Alex-Thiel/IceCutter/README.md

# IceCutter

This is the PCB and Code for the Temperature Controlled Ice Cutter for EEE4022S.
