Alex-Thiel/IceCutter/IceCutterPCB/IceCutterPCB.kicad_pcb

## KiCad design IceCutterPCB/IceCutterPCB.kicad_pcb (2022-10-09)

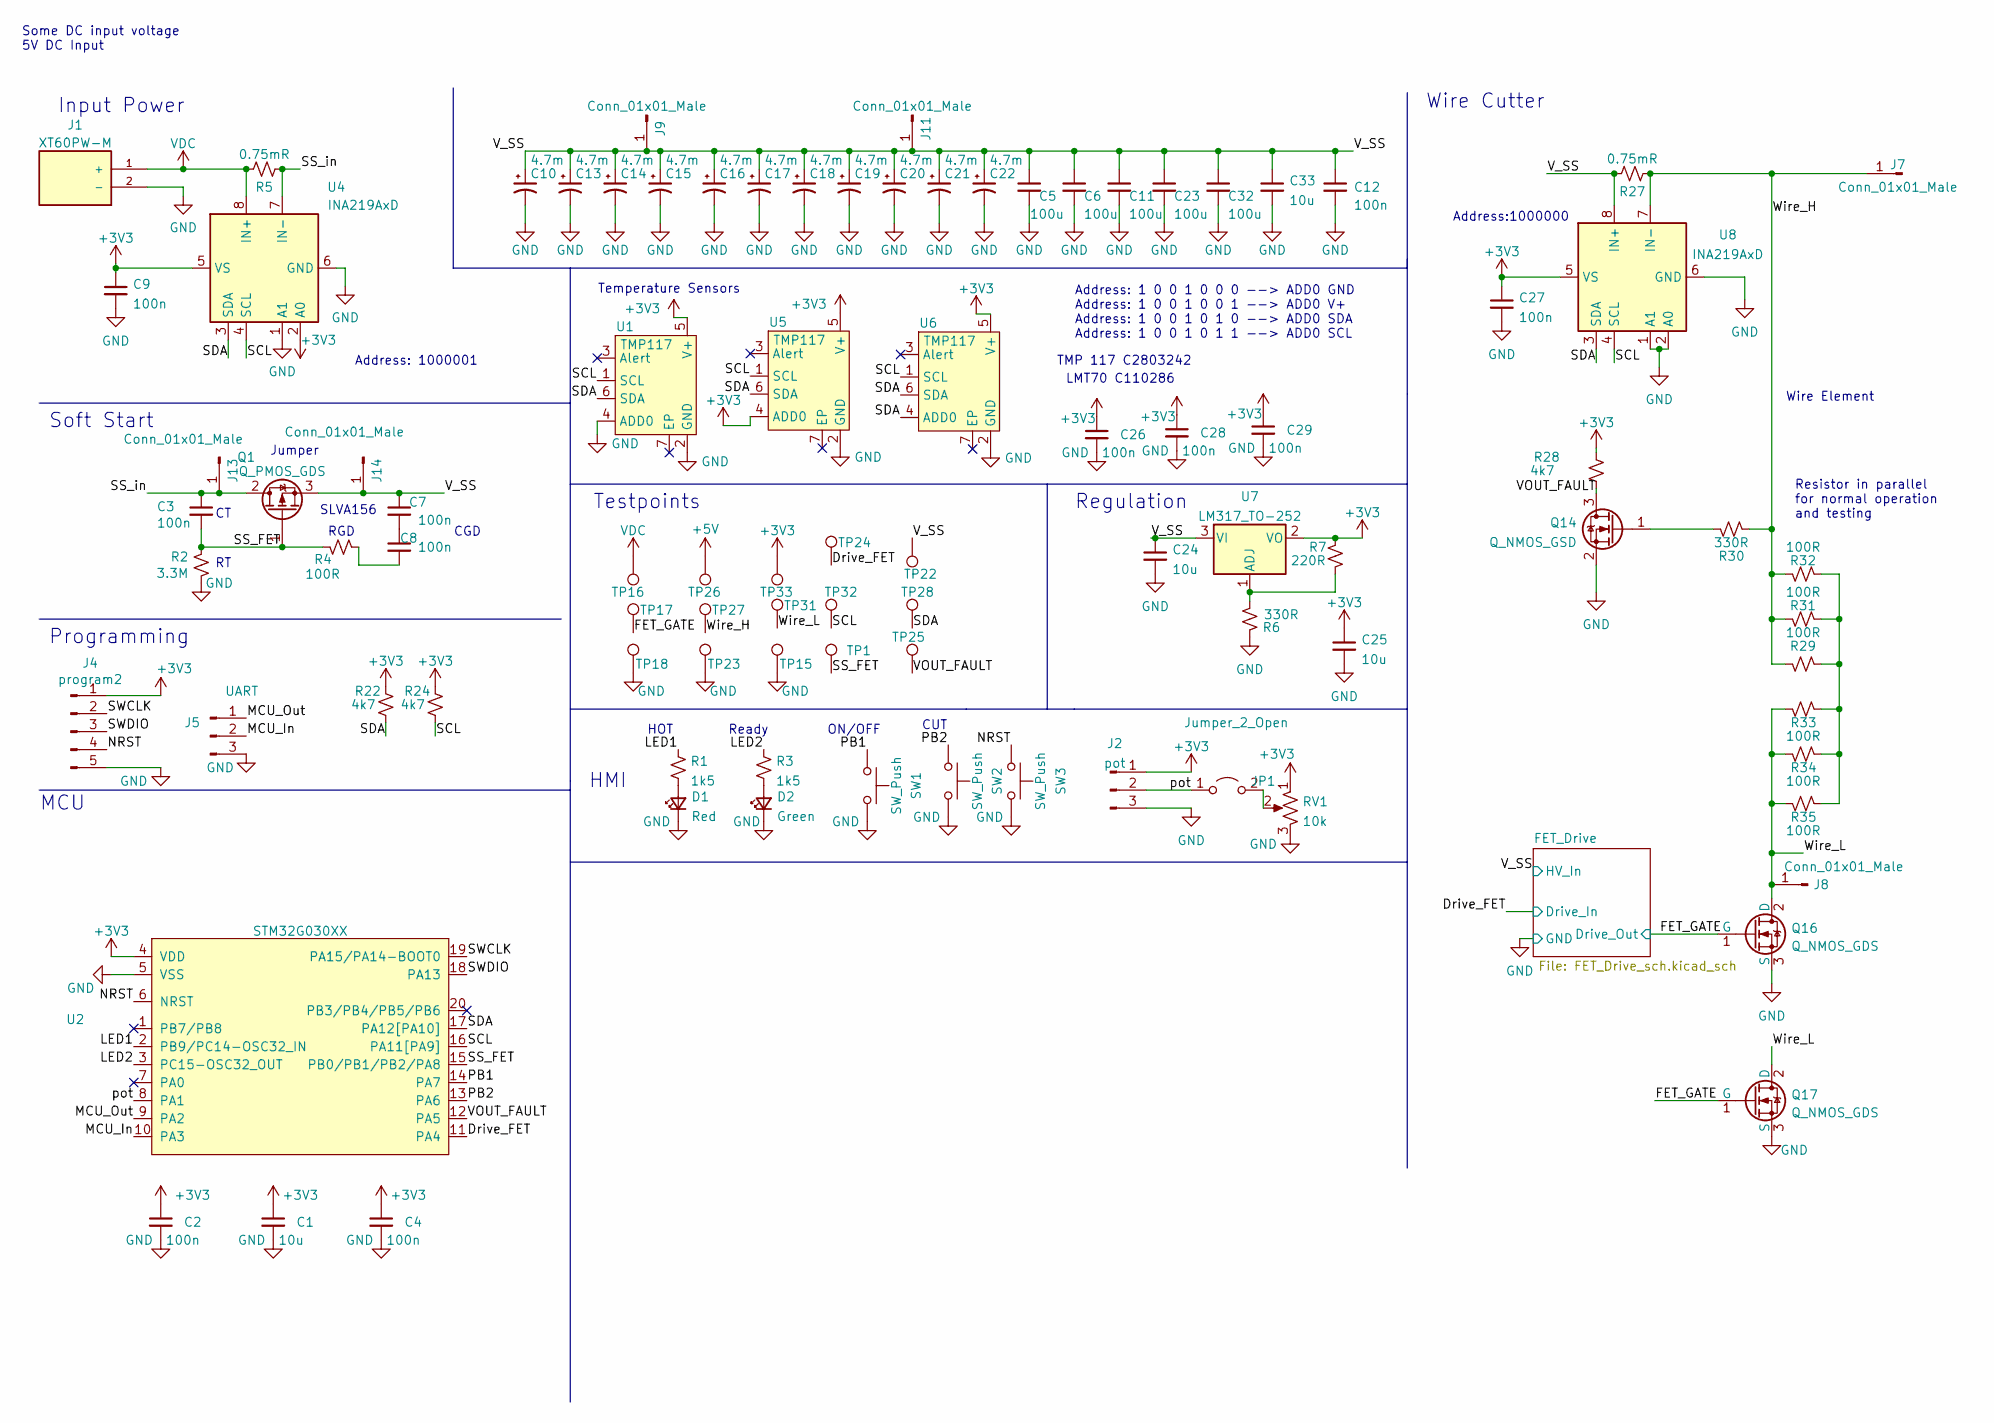
[picture p1: schematic IceCutterPCB.kicad_sch, Hot Wire Ice Cutter]

Parts:
C1, C24, C25, C33: 10u; C_0603_1608Metric; LCSC C96446
C2, C3, C4, C7, C8, C9, C12, C26, C27, C28, C29: 100n; C_0402_1005Metric; LCSC C307331
C5, C6, C11, C23, C32: 100u; C_1206_3216Metric; LCSC C15008
C10, C13, C14, C15, C16, C17, C18, C19, C20, C21, C22: 4.7m; CP_Radial_D14.0mm_P5.00mm
D1: Red; D_0603_1608Metric; LCSC C2286
D2: Green; D_0603_1608Metric; LCSC C72043
J1: XT60PW-M; AMASS_XT60PW-M; PARTREV V1.2
J2: pot; PinHeader_1x03_P2.54mm_Vertical
J4: program2; PinHeader_1x05_P2.54mm_Vertical
J5: UART; PinHeader_1x03_P2.54mm_Vertical
J7, J8, J9, J11, J13, J14: Conn_01x01_Male; SMD_Pad_15x10
JP1: Jumper_2_Open; SolderJumper-2_P1.3mm_Open_RoundedPad1.0x1.5mm
Q1: Q_PMOS_GDS; TO-252-2
Q14: Q_NMOS_GSD; SOT-23; LCSC C20917
Q16, Q17: Q_NMOS_GDS; TO-252-2; LCSC C709962
R1, R3: 1k5; R_0402_1005Metric; LCSC C25867
R2: 3.3M; R_0402_1005Metric; LCSC C25741
R4: 100R; R_0402_1005Metric; LCSC C25076
R5, R27: 0.75mR; res_5930
R6, R30: 330R; R_0402_1005Metric; LCSC C25104
R7: 220R; R_0402_1005Metric; LCSC C25091
R22, R24, R28: 4k7; R_0402_1005Metric; LCSC C25900
R29, R31, R32, R33, R34, R35: 100R; R_1206_3216Metric; LCSC C17901
RV1: 10k; RK09_THT_Pot_C209770; LCSC C209770
SW1, SW2, SW3: SW_Push; SW_SPST_TL3342; LCSC C318884
TP1, TP15, TP16, TP17, TP18, TP22, TP23, TP24, TP25, TP26, TP27, TP28, TP31, TP32, TP33: TestPoint; TestPoint_Pad_D2.0mm
U1, U5, U6: TMP117; WSON-6-1EP_2x2mm_P0.65mm_EP1x1.6mm; LCSC C2803242
U2: STM32G030XX; TSSOP-20_4.4x6.5mm_P0.65mm; LCSC C529330
U4, U8: INA219AxD; SOIC-8_3.9x4.9mm_P1.27mm; LCSC C138706
U7: LM317_TO-252; TO-252-2; LCSC C75510

Connections:
+3V3: C1.1, C2.1, C4.1, C9.1, C25.1, C26.1, C27.1, C28.1, C29.1, J2.1, J4.1, R7.2, R22.2, R24.2, R28.2, RV1.1, TP33.1, U1.5 (V+), U2.4 (VDD), U4.2 (A0), U4.5 (VS), U5.4 (ADD0), U5.5 (V+), U6.5 (V+), U7.2 (VO), U8.5 (VS)
+5V: TP26.1
/Drive_FET: TP24.1, U2.11 (PA4); also elsewhere on the board
/FET_GATE: Q16.1 (G), Q17.1 (G), TP17.1; also elsewhere on the board
/LED1: R1.1, U2.2 (PB9/PC14-OSC32_IN)
/LED2: R3.1, U2.3 (PC15-OSC32_OUT)
/MCU_In: J5.2, U2.10 (PA3)
/MCU_Out: J5.1, U2.9 (PA2)
/NRST: J4.4, SW3.1, U2.6 (NRST)
/PB1: SW1.1, U2.14 (PA7)
/PB2: SW2.1, U2.13 (PA6)
/SCL: R24.1, TP32.1, U1.1 (SCL), U2.16 (PA11[PA9]), U4.4 (SCL), U5.1 (SCL), U6.1 (SCL), U8.4 (SCL)
/SDA: R22.1, TP28.1, U1.6 (SDA), U2.17 (PA12[PA10]), U4.3 (SDA), U5.6 (SDA), U6.4 (ADD0), U6.6 (SDA), U8.3 (SDA)
/SS_FET: C3.2, Q1.1 (G), R2.1, R4.1, TP1.1, U2.15 (PB0/PB1/PB2/PA8)
/SS_in: C3.1, J13.1, Q1.2 (D), R5.2, U4.7 (IN-)
/SWCLK: J4.2, U2.19 (PA15/PA14-BOOT0)
/SWDIO: J4.3, U2.18 (PA13)
/VOUT_FAULT: Q14.3 (D), R28.1, TP25.1, U2.12 (PA5)
/V_SS: C5.1, C6.1, C7.1, C10.1, C11.1, C12.1, C13.1, C14.1, C15.1, C16.1, C17.1, C18.1, C19.1, C20.1, C21.1, C22.1, C23.1, C24.1, C32.1, C33.1, J9.1, J11.1, J14.1, Q1.3 (S), R27.1, TP22.1, U7.3 (VI), U8.8 (IN+); also elsewhere on the board
/Wire_H: J7.1, R27.2, R29.1, R30.1, R31.1, R32.1, TP27.1, U8.7 (IN-)
/Wire_L: J8.1, Q16.2 (D), Q17.2 (D), R33.2, R34.2, R35.2, TP31.1
/pot: J2.2, JP1.1 (A), U2.8 (PA1)
GND: C1.2, C2.2, C4.2, C5.2, C6.2, C9.2, C10.2, C11.2, C12.2, C13.2, C14.2, C15.2, C16.2, C17.2, C18.2, C19.2, C20.2, C21.2, C22.2, C23.2, C24.2, C25.2, C26.2, C27.2, C28.2, C29.2, C32.2, C33.2, D1.1 (K), D2.1 (K), J1.2 (-), J2.3, J4.5, J5.3, Q14.2 (S), Q16.3 (S), Q17.3 (S), R2.2, R6.1, RV1.3, SW1.2, SW2.2, SW3.2, TP15.1, TP18.1, TP23.1, U1.2 (GND), U1.4 (ADD0), U2.5 (VSS), U4.1 (A1), U4.6 (GND), U5.2 (GND), U6.2 (GND), U8.1 (A1), U8.2 (A0), U8.6 (GND); also elsewhere on the board
unnamed: C7.2, C8.1
unnamed: C8.2, R4.2
unnamed: D1.2 (A), R1.2
unnamed: D2.2 (A), R3.2
unnamed: JP1.2 (B), RV1.2
unnamed: Q14.1 (G), R30.2
unnamed: R6.2, R7.1, U7.1 (ADJ)
unnamed: R29.2, R31.2, R32.2, R33.1, R34.1, R35.1
VDC: J1.1 (+), R5.1, TP16.1, U4.8 (IN+)

Notes on the sheet:
CUT
Resistor in parallel for normal operation and testing
Some DC input voltage 5V DC Input
CGD
LMT70 C110286
Jumper
Testpoints
HOT
Input Power
Wire Element
HMI
Soft Start
SLVA156
Programming
Address: 1 0 0 1 0 0 0 --> ADD0 GND Address: 1 0 0 1 0 0 1 --> ADD0 V+ Address: 1 0 0 1 0 1 0 --> ADD0 SDA Address: 1 0 0 1 0 1 1 --> ADD0 SCL
Address: 1000001
MCU
Ready
Wire Cutter
ON/OFF
TMP 117 C2803242
Regulation
Address:1000000
Temperature Sensors
RGD

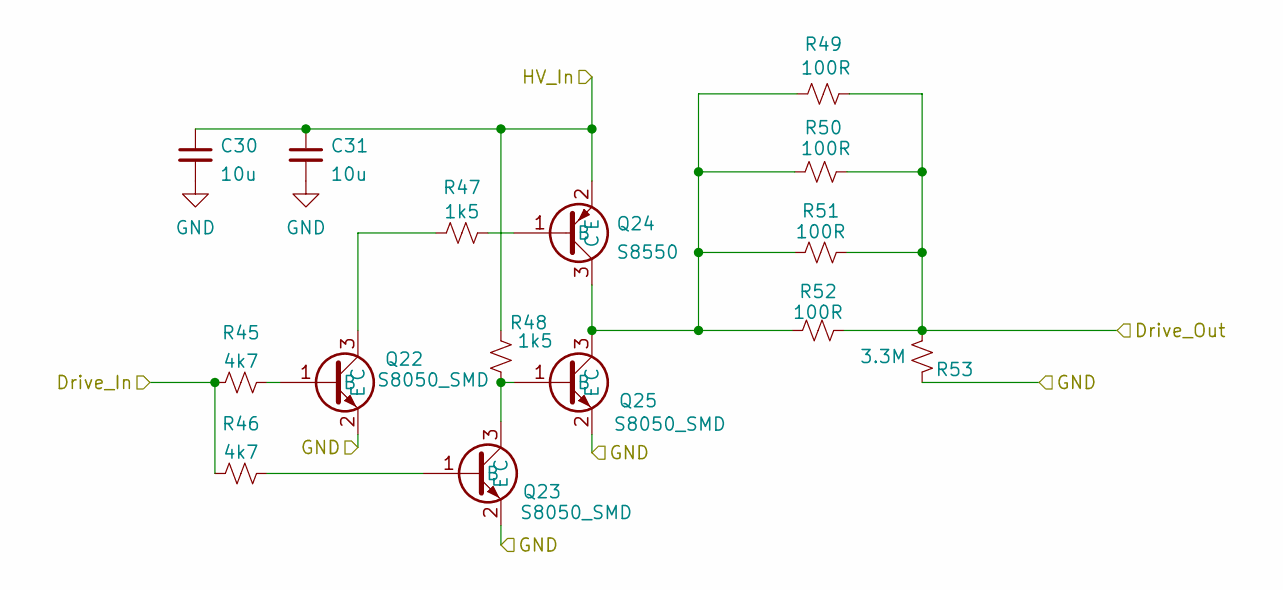
[picture p2: schematic FET_Drive_sch.kicad_sch]

Parts:
C30, C31: 10u; C_0603_1608Metric; LCSC C96446
Q22, Q23, Q25: S8050_SMD; SOT-23; LCSC C2150
Q24: S8550; SOT-23; LCSC C8542
R45, R46: 4k7; R_0402_1005Metric; LCSC C25900
R47, R48: 1k5; R_0402_1005Metric; LCSC C25867
R49, R50, R51, R52: 100R; R_0402_1005Metric; LCSC C25076
R53: 3.3M; R_0402_1005Metric; LCSC C25741

Connections:
/Drive_FET: R45.1, R46.1; also elsewhere on the board
/FET_GATE: R49.2, R50.2, R51.2, R52.2, R53.1; also elsewhere on the board
/V_SS: C30.1, C31.1, Q24.2 (E), R48.2; also elsewhere on the board
GND: C30.2, C31.2, Q22.2 (E), Q23.2 (E), Q25.2 (E), R53.2; also elsewhere on the board
unnamed: Q22.1 (B), R45.2
unnamed: Q22.3 (C), R47.1
unnamed: Q23.1 (B), R46.2
unnamed: Q23.3 (C), Q25.1 (B), R48.1
unnamed: Q24.1 (B), R47.2
unnamed: Q24.3 (C), Q25.3 (C), R49.1, R50.1, R51.1, R52.1

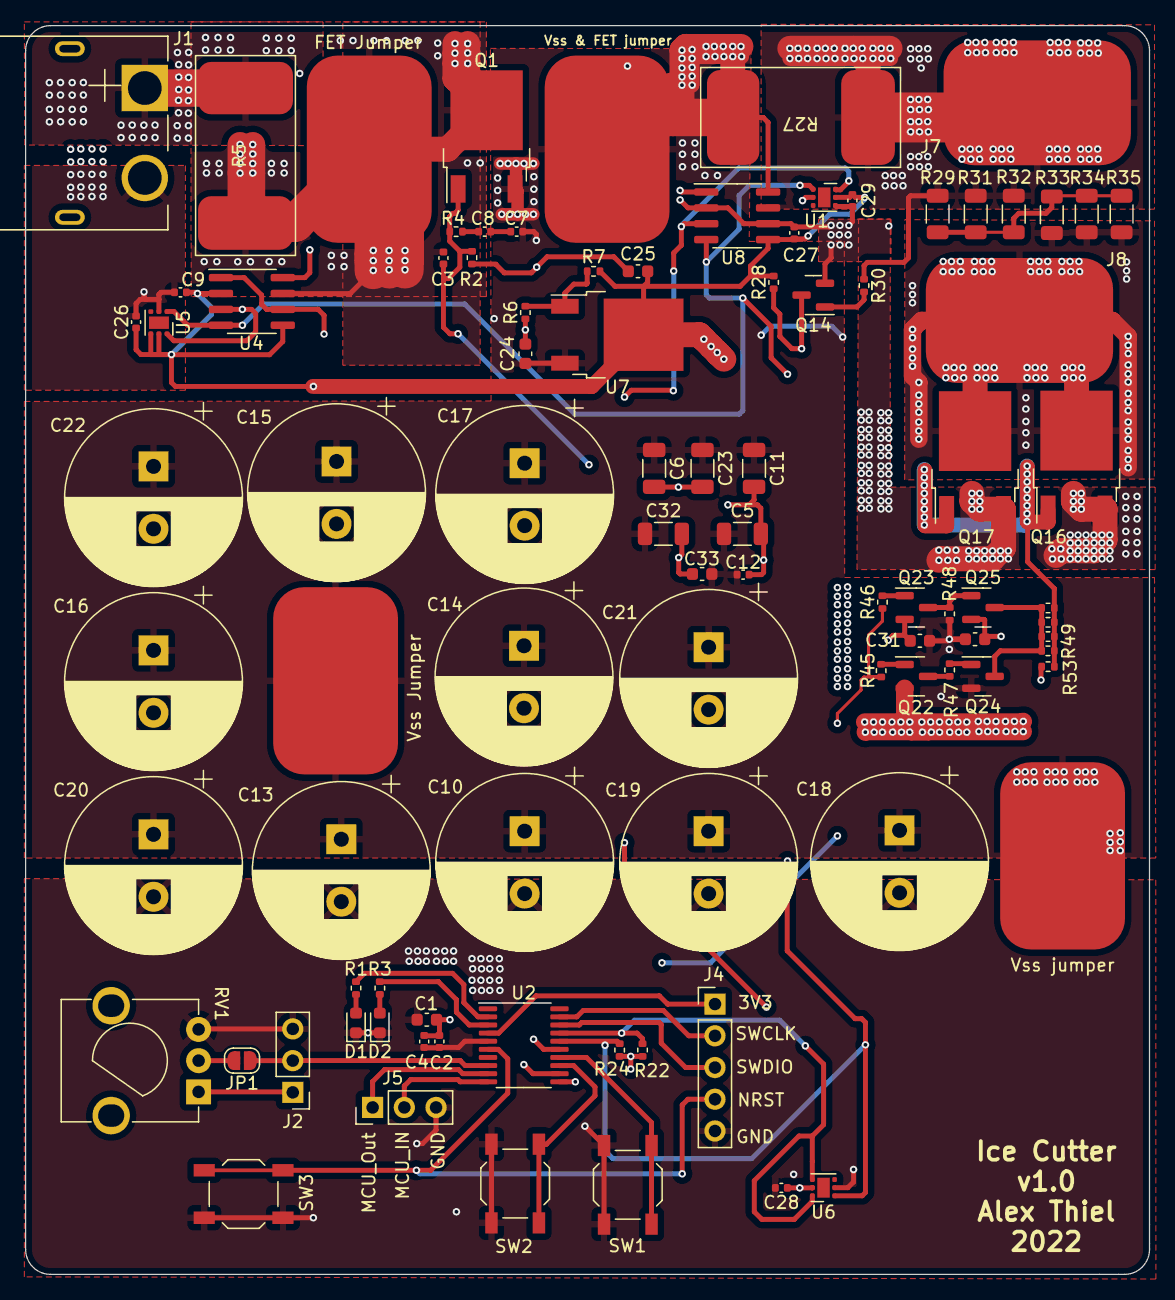
[picture p3: board IceCutterPCB.kicad_pcb from above]

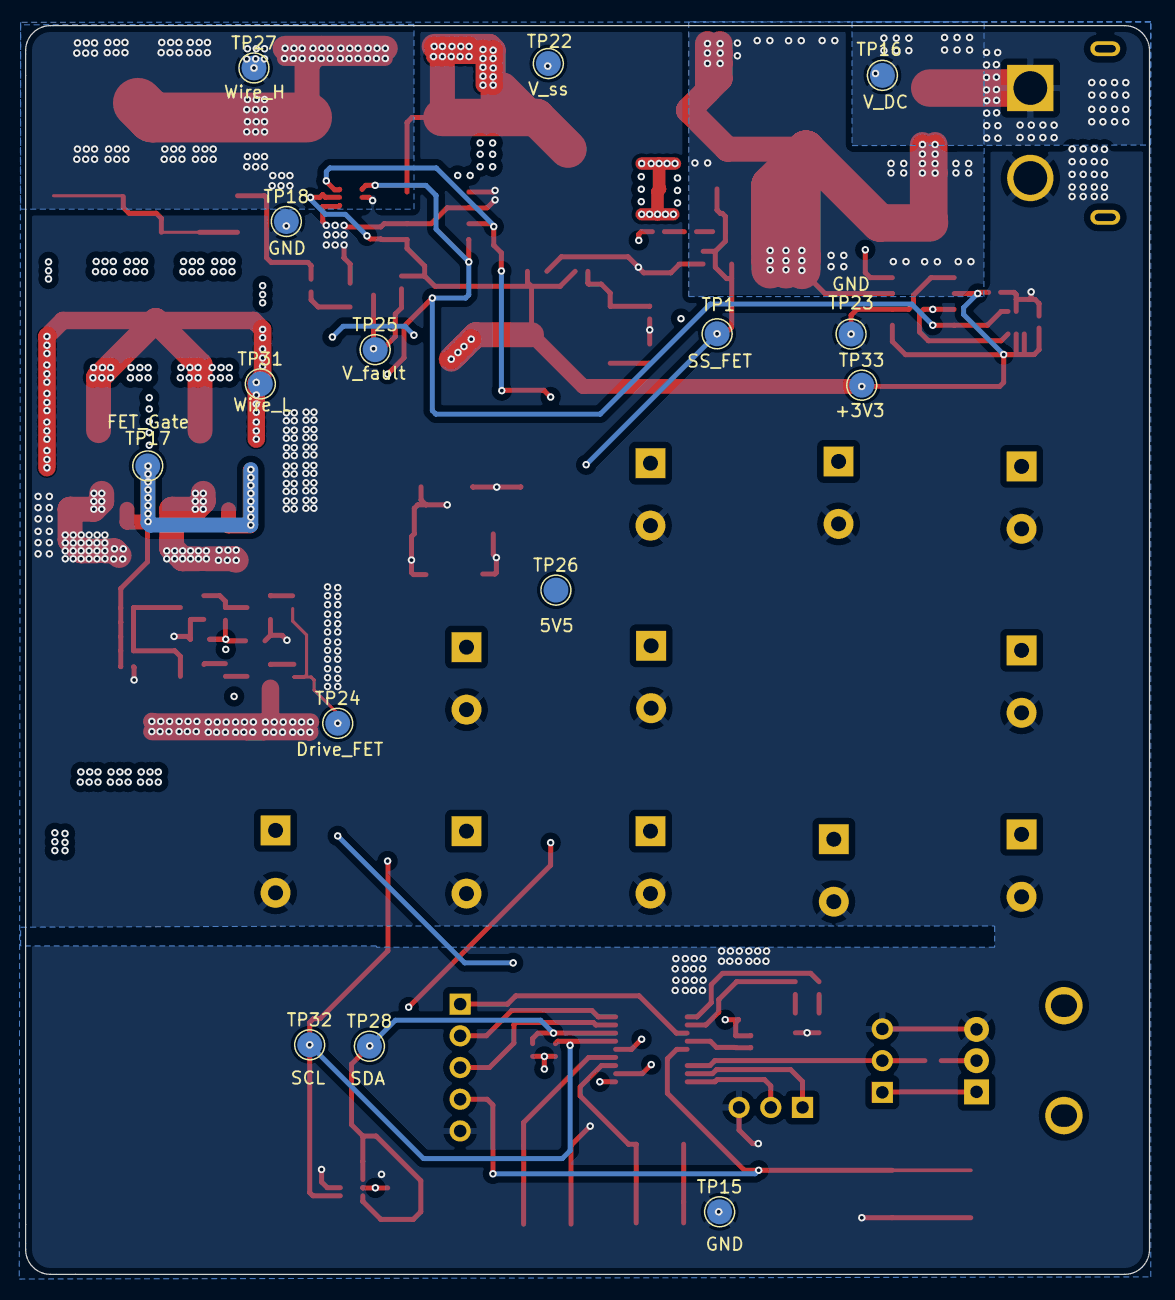
[picture p4: board IceCutterPCB.kicad_pcb from below]

Board: 4 copper layers, 90.0 x 100.0 mm, 107 parts (15 on the bottom side), 37 nets.
