Alex-Thiel/IceCutter/IceCutterTesting/IceCutterTesting.ioc

Mcu.UserName=STM32G030F6Px
PA1.Signal=ADC1_IN1
PA13.Signal=SYS_SWDIO
PA14-BOOT0.Signal=SYS_SWCLK
PA2.Signal=USART2_TX
PA3.Signal=USART2_RX
PA4.Signal=S_TIM14_CH1
PA5.Signal=GPIO_Input
PA6.Signal=GPXTI6
PA7.Signal=GPXTI7
PB0.Signal=GPIO_Output
PB5.Signal=S_TIM3_CH2
PB9.Signal=GPIO_Output
