Alex-Thiel/IceCutter/(commit log)

2022-10-09 Added PCB
    [BOM-IceCutterPCB.csv, FET_Drive_sch.kicad_sch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]
2022-10-10 Changed UART to global variables
2022-10-10 Added button procedure
2022-10-10 Interrupt flags being cleared correctly
    [main.c]
2022-10-12 Changed GPIO pins to new board
2022-10-16 Added input current monitoring
2022-10-16 Working current display
2022-10-17 Changed PWM to interrupt
2022-10-18 Added temp error handling
    [IceCutterTesting.ioc, main.c]
2022-10-18 Altered current measuring timing
2022-10-18 converted buttons to pull-up resistors
2022-10-20 Working 2.15ms current reading delay
2022-10-20 Measuring wire output voltage, duty cycle linked to pot
